27Mayibongwe/Design-of-Brushless-DC-Motor-Controller-Using-Pulse-Width-Modulation-PWM-/README.md

# Design-of-Brushless-DC-Motor-Controller-Using-Pulse-Width-Modulation-PWM-
