27Mayibongwe/Design-of-Brushless-DC-Motor-Controller-Using-Pulse-Width-Modulation-PWM-/circuit diagram.JPG

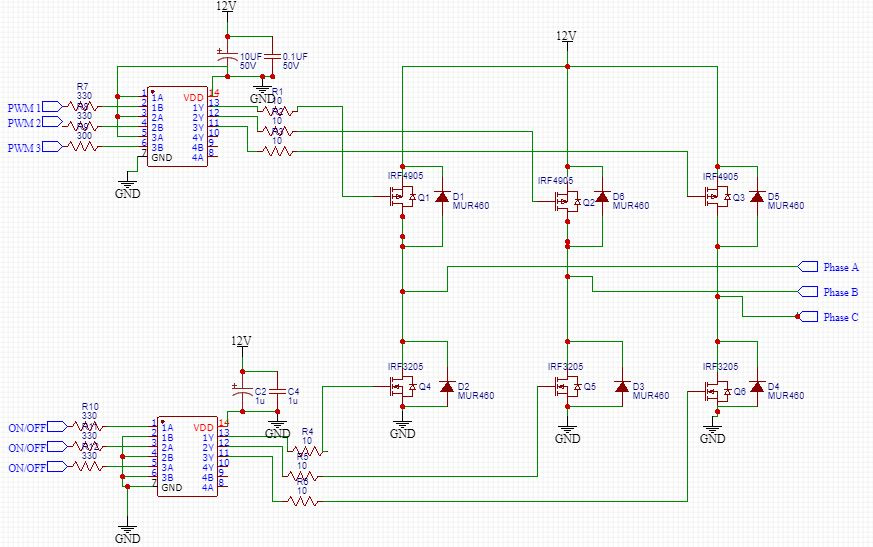
circuit diagram.JPG
